chschu/wificlock/hardware/datasheets/CL5643AH.jpg

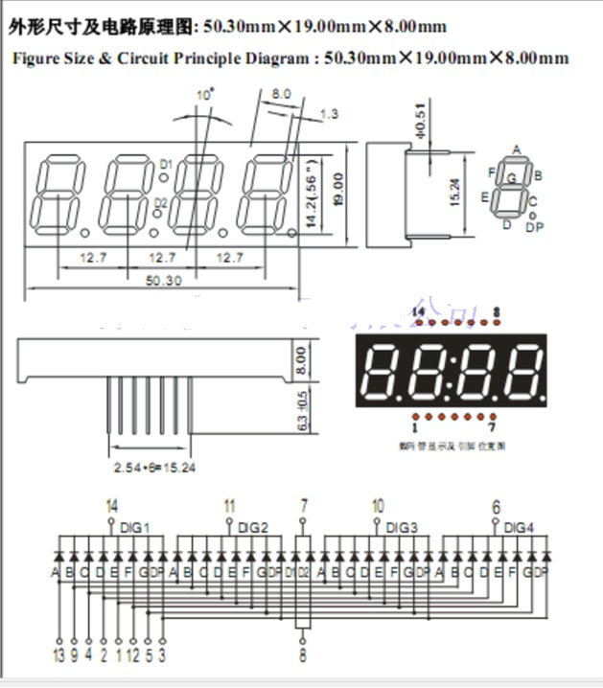
hardware/datasheets/CL5643AH.jpg
