chschu/wificlock/hardware/datasheets/tactile-switch-side.jpg

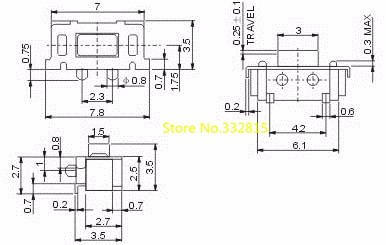
hardware/datasheets/tactile-switch-side.jpg
