chschu/wificlock/case/case.step

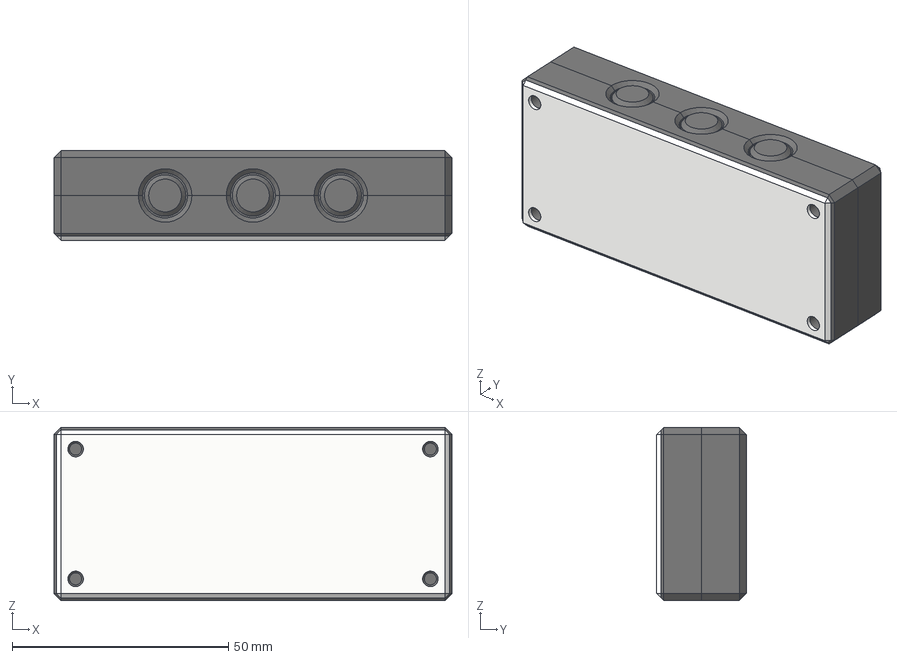
[picture p3: CAD file, 2021-05-23]
case/case.step
92.0 x 20.7 x 40.0 mm
Front
Back
Screen Protection
Button L
Button M
Button R
