chschu/wificlock/(list of files, drawings)

Other design files:
hardware/wificlock.dsn
