chschu/wificlock/hardware/wificlock.kicad_pcb

## KiCad design hardware/wificlock.kicad_pcb (2021-04-26)

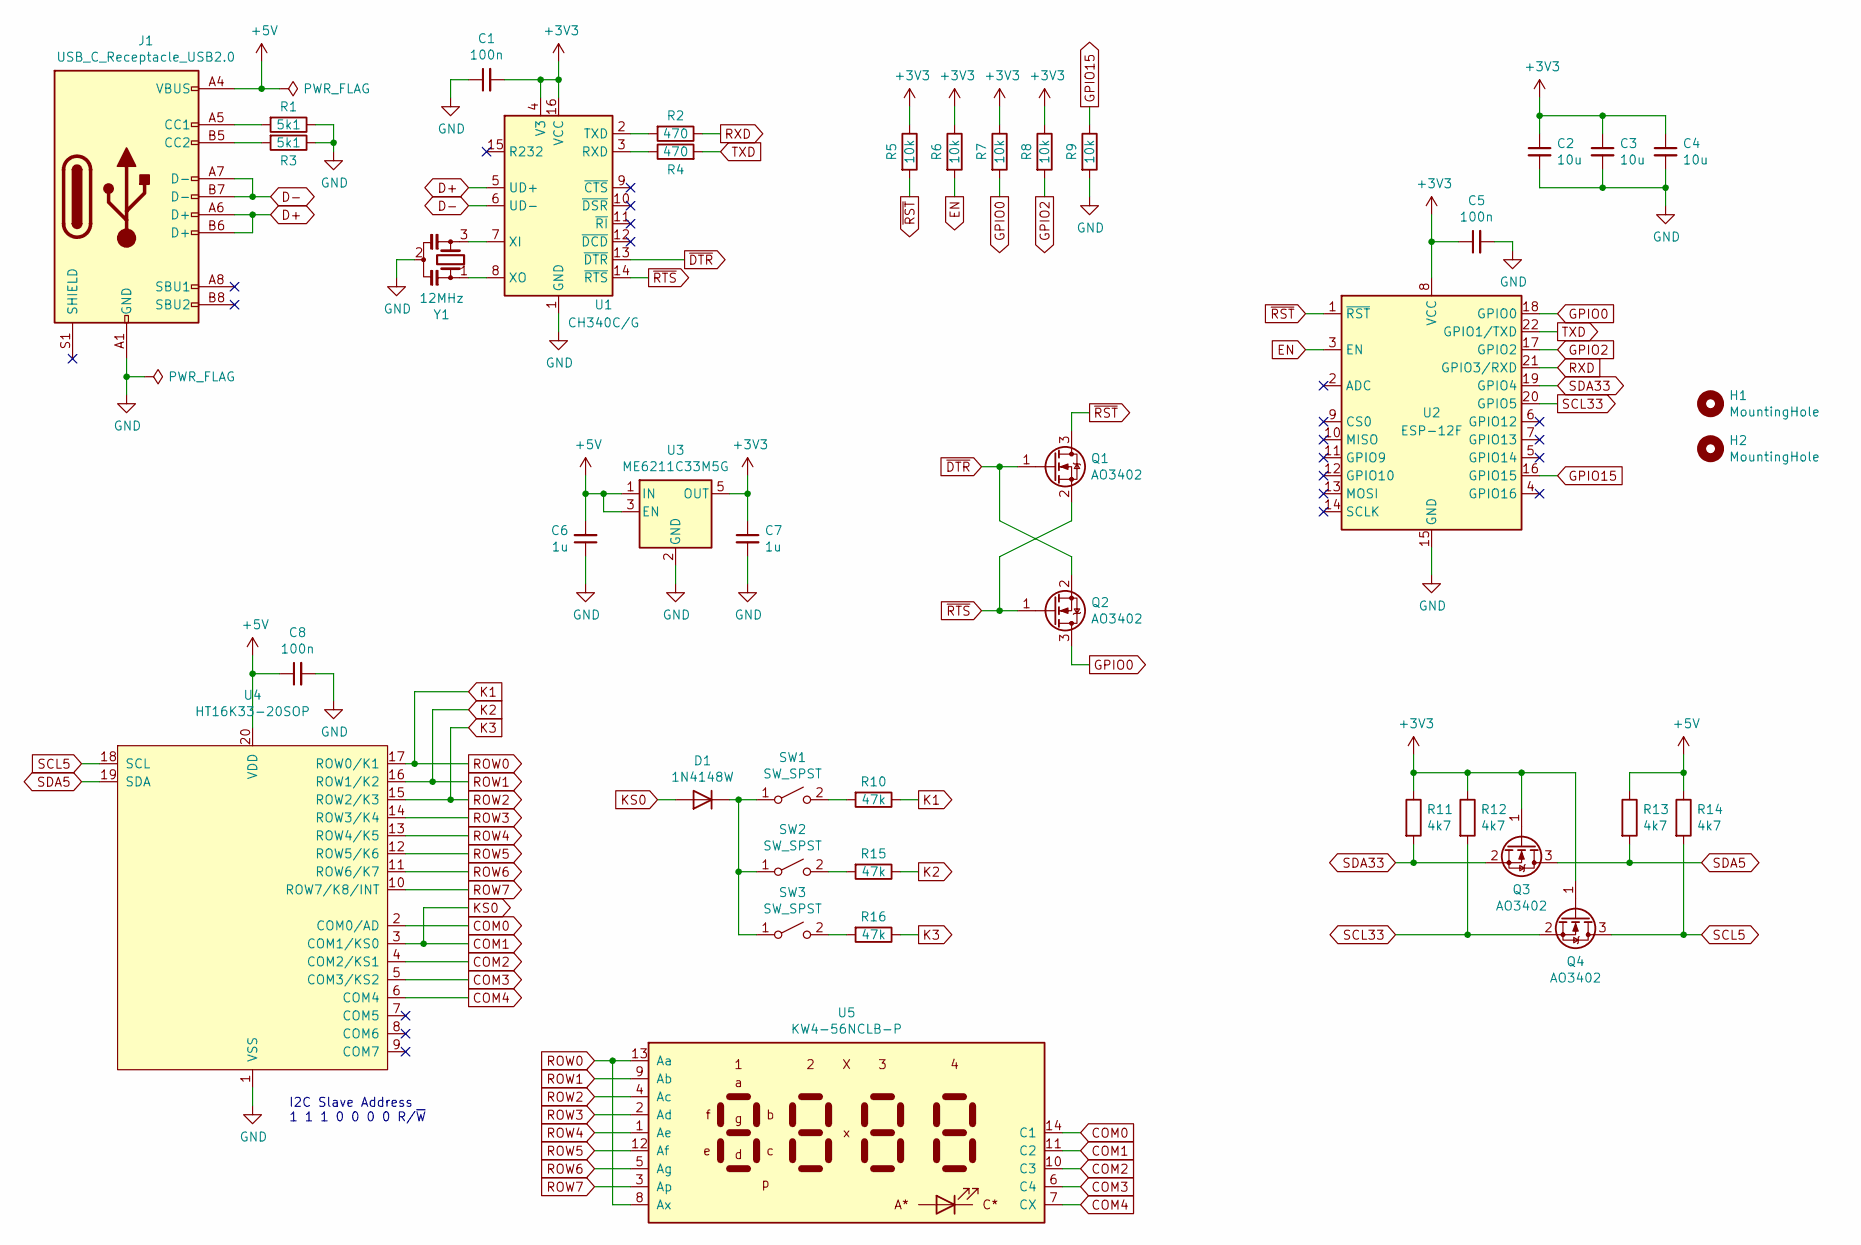
[picture p4: schematic wificlock.sch]

Parts:
C1, C5, C8: 100n; C_0805_2012Metric
C2, C3, C4: 10u; C_0805_2012Metric
C6, C7: 1u; C_0805_2012Metric
D1: 1N4148W; D_SOD-123
H1, H2: MountingHole; MountingHole_3.2mm_M3_ISO14580
J1: USB_C_Receptacle_USB2.0; USB_C_Receptacle_UT03FD014SX01ZA_Vertical
Q1, Q2, Q3, Q4: AO3402; SOT-23
R1, R3: 5k1; R_0805_2012Metric
R2, R4: 470; R_0805_2012Metric
R5, R6, R7, R8, R9: 10k; R_0805_2012Metric
R10, R15, R16: 47k; R_0805_2012Metric
R11, R12, R13, R14: 4k7; R_0805_2012Metric
SW1, SW2, SW3: SW_SPST; SW_SPST_SMD_3x6x3.5_Side
U1: CH340C/G; SOIC-16_3.9x9.9mm_P1.27mm
U2: ESP-12F; ESP-12E
U3: ME6211C33M5G; SOT-23-5
U4: HT16K33-20SOP; SOIC-20W_7.5x12.8mm_P1.27mm
U5: KW4-56NCLB-P; KW4-56NXLB-P
Y1: 12MHz; Resonator_SMD_muRata_CSTxExxV-3Pin_3.0x1.1mm

Connections:
+3V3: C1.2, C2.1, C3.1, C4.1, C5.1, C7.1, Q3.1 (G), Q4.1 (G), R5.1, R6.1, R7.1, R8.1, R11.1, R12.1, U1.4 (V3), U1.16 (VCC), U2.8 (VCC), U3.5 (OUT)
+5V: C6.2, C8.1, J1.A4 (VBUS), J1.A9 (VBUS), J1.B4 (VBUS), J1.B9 (VBUS), R13.1, R14.1, U3.1 (IN), U3.3 (EN), U4.20 (VDD)
COM0: U4.2 (COM0/AD), U5.14 (C1)
COM1: D1.2 (A), U4.3 (COM1/KS0), U5.11 (C2)
COM2: U4.4 (COM2/KS1), U5.10 (C3)
COM3: U4.5 (COM3/KS2), U5.6 (C4)
COM4: U4.6 (COM4), U5.7 (CX)
D+: J1.A6 (D+), J1.B6 (D+), U1.5 (UD+)
D-: J1.A7 (D-), J1.B7 (D-), U1.6 (UD-)
EN: R6.2, U2.3 (EN)
GND: C1.1, C2.2, C3.2, C4.2, C5.2, C6.1, C7.2, C8.2, J1.A1 (GND), J1.A12 (GND), J1.B1 (GND), J1.B12 (GND), R1.1, R3.1, R9.2, U1.1 (GND), U2.15 (GND), U3.2 (GND), U4.1 (VSS), Y1.2
GPIO0: Q2.3 (D), R7.2, U2.18 (GPIO0)
GPIO2: R8.2, U2.17 (GPIO2)
GPIO15: R9.1, U2.16 (GPIO15)
K1: R10.1, U4.17 (ROW0/K1), U5.8 (Ax), U5.13 (Aa)
K2: R15.1, U4.16 (ROW1/K2), U5.9 (Ab)
K3: R16.1, U4.15 (ROW2/K3), U5.4 (Ac)
unnamed: D1.1 (K), SW1.1 (A), SW2.1 (A), SW3.1 (A)
unnamed: J1.A5 (CC1), R1.2
unnamed: J1.B5 (CC2), R3.2
unnamed: R2.2, U1.2 (TXD)
unnamed: R4.1, U1.3 (RXD)
unnamed: R10.2, SW1.2 (B)
unnamed: R15.2, SW2.2 (B)
unnamed: R16.2, SW3.2 (B)
unnamed: U1.7 (XI), Y1.3
unnamed: U1.8 (XO), Y1.1
ROW3: U4.14 (ROW3/K4), U5.2 (Ad)
ROW4: U4.13 (ROW4/K5), U5.1 (Ae)
ROW5: U4.12 (ROW5/K6), U5.12 (Af)
ROW6: U4.11 (ROW6/K7), U5.5 (Ag)
ROW7: U4.10 (ROW7/K8/INT), U5.3 (Ap)
RXD: R2.1, U2.21 (GPIO3/RXD)
SCL5: Q4.3 (D), R14.2, U4.18 (SCL)
SCL33: Q4.2 (S), R12.2, U2.20 (GPIO5)
SDA5: Q3.3 (D), R13.2, U4.19 (SDA)
SDA33: Q3.2 (S), R11.2, U2.19 (GPIO4)
TXD: R4.2, U2.22 (GPIO1/TXD)
~DTR: Q1.1 (G), Q2.2 (S), U1.13 (~DTR)
~RST: Q1.3 (D), R5.2, U2.1 (~RST)
~RTS: Q1.2 (S), Q2.1 (G), U1.14 (~RTS)

Notes on the sheet:
I2C Slave Address 1 1 1 0 0 0 0 R/~W~

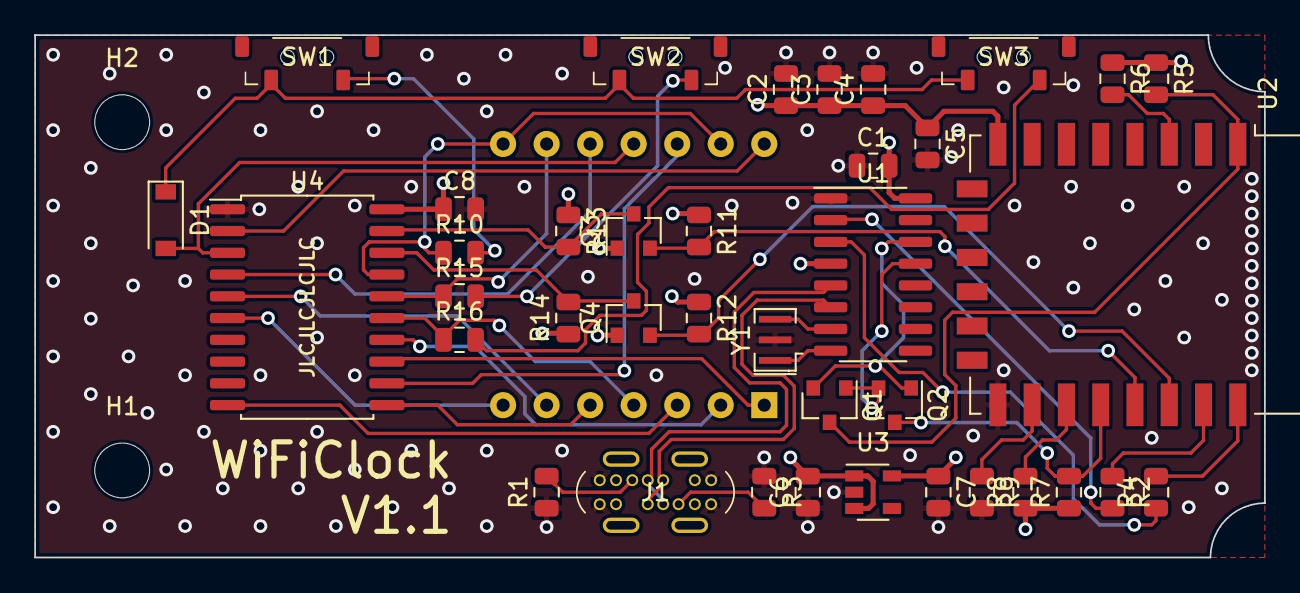
[picture p5: board wificlock.kicad_pcb from above]

Board: 4 copper layers, 71.8 x 30.5 mm, 41 parts (1 on the bottom side), 41 nets.
