chschu/wificlock/(commit log)

2021-01-08 increase bit rate for TM1637 (after desoldering too large capacitors)
    [main.cpp]
2021-01-11 switch to TM16xx library that supports reading keys
2021-02-15 switch to HT16K33 with CL5643AH display
2021-02-15 use more intuitive LED mapping that also works for 20-pin variant of HT16K33
2021-02-15 add schematic
    [wificlock.sch]
2021-02-28 add footprints for display and tactile side switch
    [wificlock.sch]
2021-03-25 extract button and display state handling to class
2021-03-27 fix i2c_read and buffer size
2021-03-30 add pcb and footprints
    [wificlock.kicad_pcb, wificlock.sch]
2021-03-30 manually route IC decoupling and some other critical traces
    [wificlock.kicad_pcb]
2021-03-31 autoroute and small manual routing fixes
    [wificlock.dsn, wificlock.kicad_pcb]
2021-03-31 use correct diode model
    [wificlock.kicad_pcb, wificlock.sch]
2021-03-31 add order number marker for JLCPCB
    [wificlock.kicad_pcb]
2021-03-31 via stitching
    [wificlock.kicad_pcb]
2021-03-31 some more minor routing fixes
    [wificlock.kicad_pcb]
2021-03-31 change via and pad hole sizes to 0.45 mm to match JLCPCB production
    [wificlock.kicad_pcb]
2021-03-31 add Gerber files for V1.0
    [wificlock-B_Cu.gbr, wificlock-B_Mask.gbr, wificlock-B_Paste.gbr, wificlock-B_SilkS.gbr, wificlock-Edge_Cuts.gbr, wificlock-F_Cu.gbr, wificlock-F_Mask.gbr, wificlock-F_Paste.gbr]
2021-04-05 add 3D models for footprints
    [wificlock.kicad_pcb, wificlock.sch]
2021-04-06 update KiCad
    [wificlock.kicad_pcb, wificlock.sch]
2021-04-16 fix display footprint to match actual hardware (only changes silkscreen on PCB)
    [wificlock.kicad_pcb]
2021-04-18 fix case fallbck
2021-04-22 enable access point if all three buttons are pressed during startup, enable station mode otherwise (AP is unstable while STA is scanning channels for its configured network)
    [main.cpp]
2021-04-26 move components to align (center) display, USB receptacle and switches; minor routing optimizations; update Gerber files
    [wificlock-B_Cu.gbr, wificlock-B_Mask.gbr, wificlock-B_Paste.gbr, wificlock-B_SilkS.gbr, wificlock-Edge_Cuts.gbr, wificlock-F_Cu.gbr, wificlock-F_Mask.gbr, wificlock-F_Paste.gbr]
2021-05-06 change to generic board
2021-05-23 generalize serial port device path
2021-05-23 setup access point (takes almost a second on some chips) before starting display to avoid unresponsive delay
    [main.cpp]
2021-05-23 add STEP file for case (includes PCB)
    [case.step]
